Breandan-Gillanders/Masters_Project/Weekly_Reports/ProjectMeeting_2025_10_29.pptx

## Project Meeting

29/10/2025

## Summary of Past Week

- Literature Review:
  - Reading on methods for measuring reflection coefficient/extracting resonant frequency from wireless LC sensors.
  - Reading on existing sensors.
  - Taking notes on papers.
- Getting current circuit up and running:
  - Tested DDS output and filtered output on oscilloscope.
  - Looking over the Arduino code.
- Finalising project plan.

## Phase-Dip Method (current method)

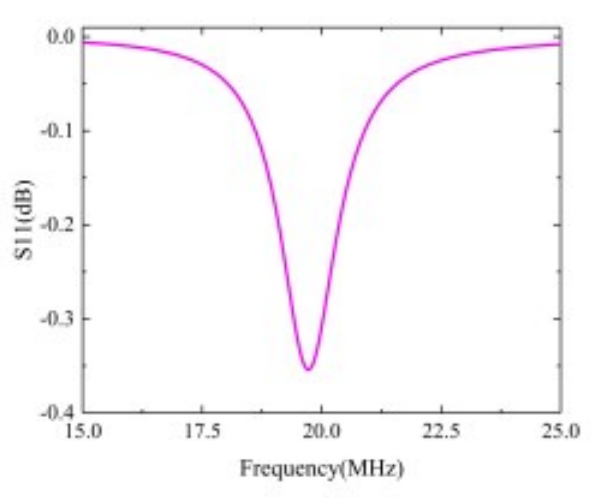
[picture p1: figure]

- Measure phase difference between DDS output and transmitted signal.
- Resonant frequency of sensor is ‘near’ the minimum in the phase curve.
- Dependent on coupling coefficient.
- Can be measured with phase detector.
- Requires compensation.

f_(phase−dip) ≈(1+(k^2)/4+1/(8Q^2))f_s

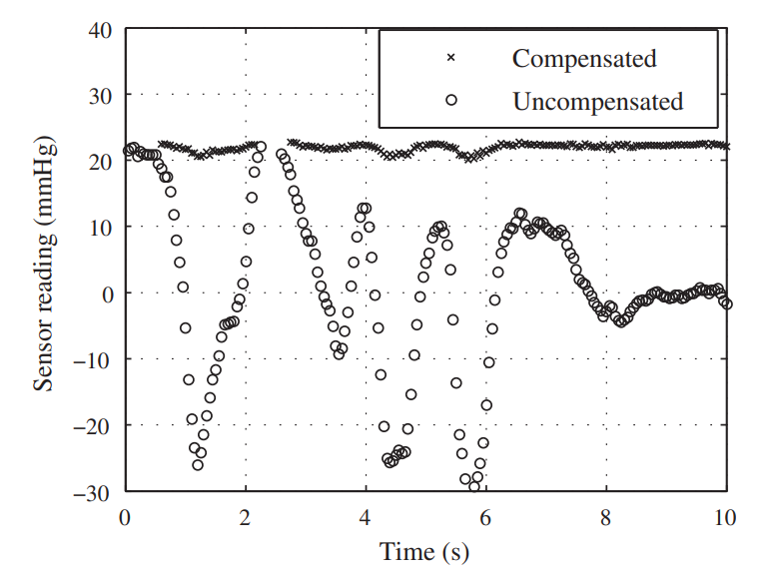
[picture p2: figure]

## Slide 4

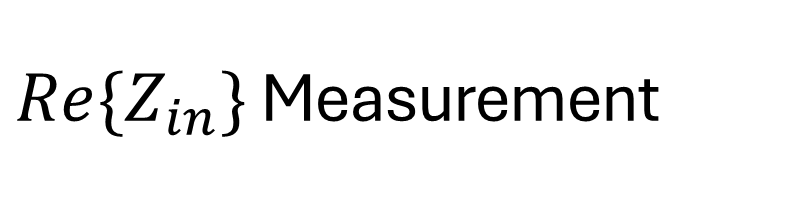
[picture p3: figure]

- Measures real component of readout coil impedance.
- The maximum occurs very close to the sensors resonance frequency.
- Minimally affected by coupling variations (independent of k).
- Can be measured with SWR bridge.

f_(max⁡(Re)) ≈(1+1/(4Q^2))f_s

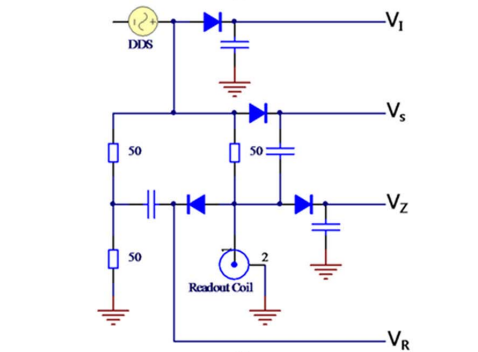
[picture p4: figure]
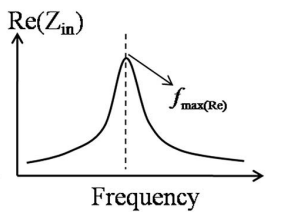
[picture p5: figure]

## Plan for Next Week

- Look into the phase shifter circuitry.
- Get full circuit running:
  - Need transmitter coil.
- Continue reviewing literature.
  - Look into operation of SWR bridge.
