Breandan-Gillanders/Masters_Project/Weekly_Reports/ProjectMeeting_2025_11_05.pptx

## Project Meeting

05/11/2025

## Summary of Past Week

- Literature Review:
  - Reading patents of existing readout systems.
- Getting current circuit up and running:
  - Looking into how the phase shifter works.
  - Simulating the phase shifter.
- Simulating different methods for extracting the resonance frequency.
  - Phase dip method
  - SWR Bridge (measuring real component of coil impedance)
  - Current Source Method (measuring real component of coil impedance)

## Vesselsens readout system

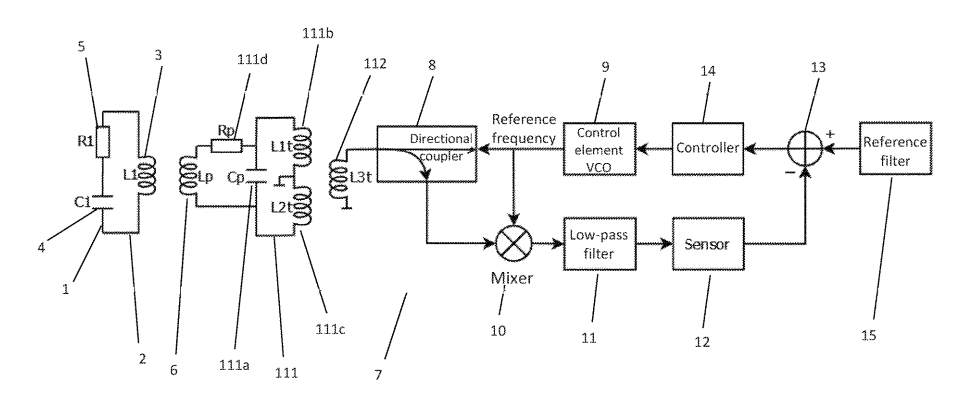
[picture p6: figure]

## Fire1 Readout System

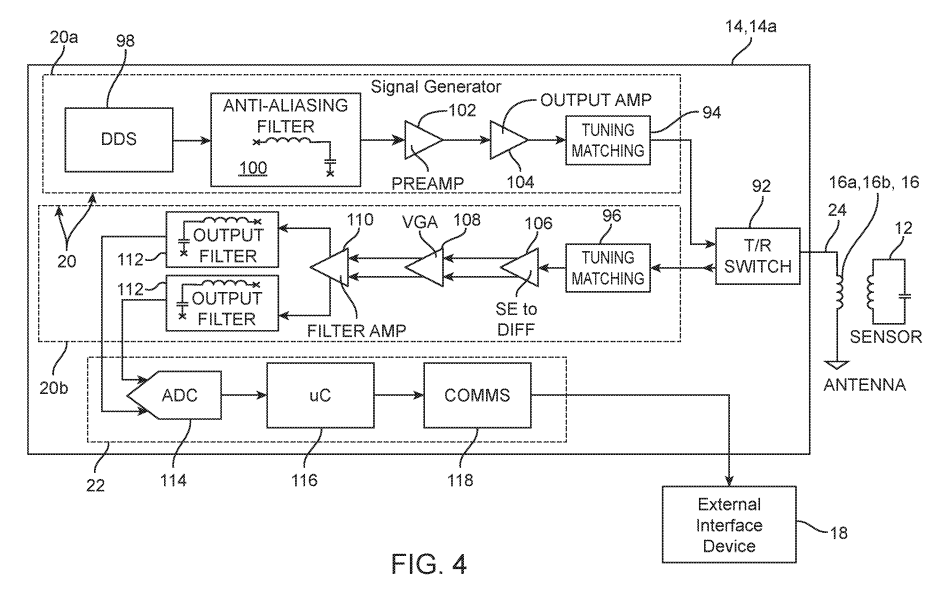
[picture p7: figure]

## Phase Shifter

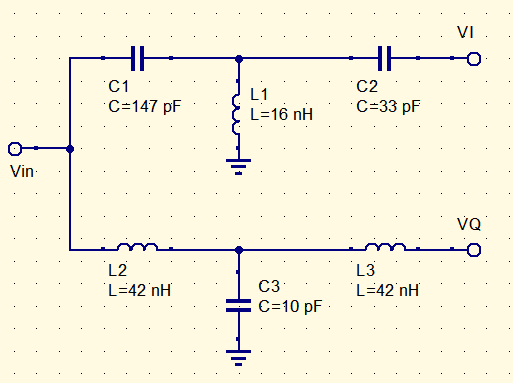
[picture p8: figure]
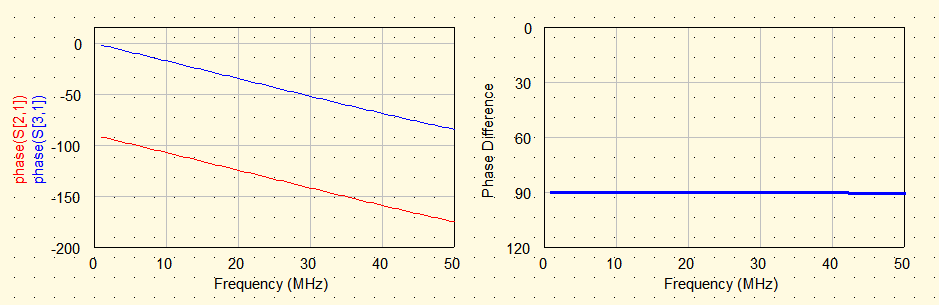
[picture p9: figure]

## Plan for Next Week

- Work on getting readings from current circuit.
- Continue Literature Review:
  - Review general methods for reading transmission/reflection coefficients.
