Breandan-Gillanders/Masters_Project/Papers/Litererature_Review_Notes.docx

## Wireless Readout of Passive LC Sensors [1]

This paper presents analytical expressions and practical circuitry for wirelessly reading passive LC resonant sensors using inductive coupling.

The paper first derives a mathematical model describing how the impedance at the readout coil depends on the sensor’s parameters and coupling.

The paper then evaluates previously used readout techniques, including phase dip detection and dip meter oscillators, showing that these approaches fail or become inaccurate when the sensor and readout coils are placed too close (i.e., when the coupling coefficient becomes large).

The paper then proposes an architecture to address these limitations based on measuring the real component of the input coil impedance.

## Wireless interrogation techniques for sensors utilizing inductively coupled resonance circuits [2]

This paper presents methods and instrumentation for wirelessly reading passive LC resonance sensors using inductive coupling. The authors develop a compact, portable impedance measurement unit capable of sweeping over a frequency range to record the phase and magnitude response of a resonant sensor. The system’s post-processing software identifies the resonance frequency and compensates for motion-induced errors caused by variations in the coupling coefficient.

The paper explains how the coupling between the reader and sensor coils affects the detected resonance frequency, leading to measurement ambiguity. To address this, a compensation algorithm relates the resonance peak frequency to the height of the phase peak, enabling correction for changes in coupling.

## Enhancing LC Sensor Telemetry via Magnetic Resonance Coupling [3]

This paper introduces a magnetic resonance–coupled reader designed to improve the signal strength and readout distance of passive LC wireless sensors. Conventional LC sensor systems suffer from weak coupling and limited range when sensor dimensions are reduced. To overcome this, the authors propose a resonant reader with a tuneable frequency, adjusted via a varactor diode, that can align its resonance with that of the sensor to achieve magnetic resonance coupling.

## Readout methods for an inductively coupled resonance sensor used in pressure garment application [4]

This paper details a portable device that performs frequency sweeps across the sensor’s resonance range while recording phase response data. A PC-based post-processing algorithm extracts two key features from the phase curve—the resonance peak frequency and height—and uses their relationship to correct for errors caused by changes in coil distance or alignment. The compensated resonance frequency is then converted into pressure using a calibrated sensitivity factor.

## An LC-Type Passive Wireless Humidity Sensor System With Portable Telemetry Unit [5]

The sensor is wirelessly interrogated using a custom-made telemetry unit based on a standing wave ratio (SWR) bridge that measures the real part of the readout coil impedance. This approach eliminates errors due to varying coupling coefficients that affect conventional phase-dip methods. The system uses a direct digital synthesizer (DDS) for frequency sweeps and a microcontroller to process and transmit data to a PC for visualization.

[1] R. Nopper, R. Niekrawietz, and L. Reindl, ‘Wireless readout of passive LC sensors’, IEEE Trans Instrum Meas, vol. 59, no. 9, pp. 2450–2457, Sep. 2010, doi: 10.1109/TIM.2009.2032966.

[2] T. Salpavaara, J. Verho, P. Kumpulainen, and J. Lekkala, ‘Wireless interrogation techniques for sensors utilizing inductively coupled resonance circuits’, Procedia Eng, vol. 5, pp. 216–219, Jan. 2010, doi: 10.1016/J.PROENG.2010.09.086.

[3] B. Bin Zhou, M. N. Zhang, M. Z. Xie, L. F. Wang, and Q. A. Huang, ‘Enhancing LC Sensor Telemetry via Magnetic Resonance Coupling’, Proceedings of IEEE Sensors, vol. 2019-October, Oct. 2019, doi: 10.1109/SENSORS43011.2019.8956818.

[4] T. Salpavaara, J. Verho, P. Kumpulainen, and J. Lekkala, ‘Readout methods for an inductively coupled resonance sensor used in pressure garment application’, Sens Actuators A Phys, vol. 172, no. 1, pp. 109–116, Dec. 2011, doi: 10.1016/J.SNA.2011.02.051.

[5] C. Zhang, L. F. Wang, J. Q. Huang, and Q. A. Huang, ‘An LC-type passive wireless humidity sensor system with portable telemetry unit’, Journal of Microelectromechanical Systems, vol. 24, no. 3, pp. 575–581, Jun. 2015, doi: 10.1109/JMEMS.2014.2333747.
