Breandan-Gillanders/Masters_Project/Inductions/Breandan-Gillanders-University-of-Galway-8211-Fire-Safety-Awareness-Training-University-of-Galway-–-Fire-Safety-Awareness-Trainin.pdf

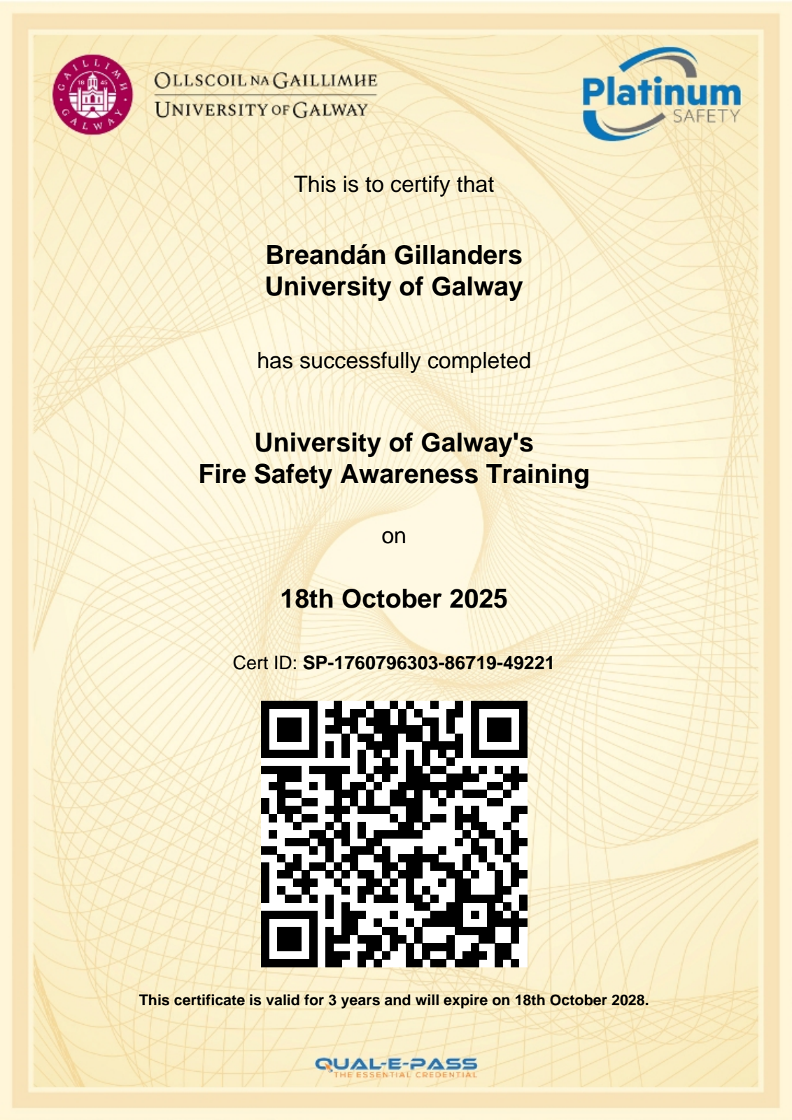
[picture p10: page 1]

This is to certify that

Breandán Gillanders
University of Galway

has successfully completed

University of Galway's
Fire Safety Awareness Training

on

18th October 2025

Cert ID: SP-1760796303-86719-49221

This certificate is valid for 3 years and will expire on 18th October 2028.

Powered by TCPDF (www.tcpdf.org)
