Breandan-Gillanders/Masters_Project/Inductions/CSWL2-25_Chemical Safety in the Workplace – Level 2 Certificate.pdf

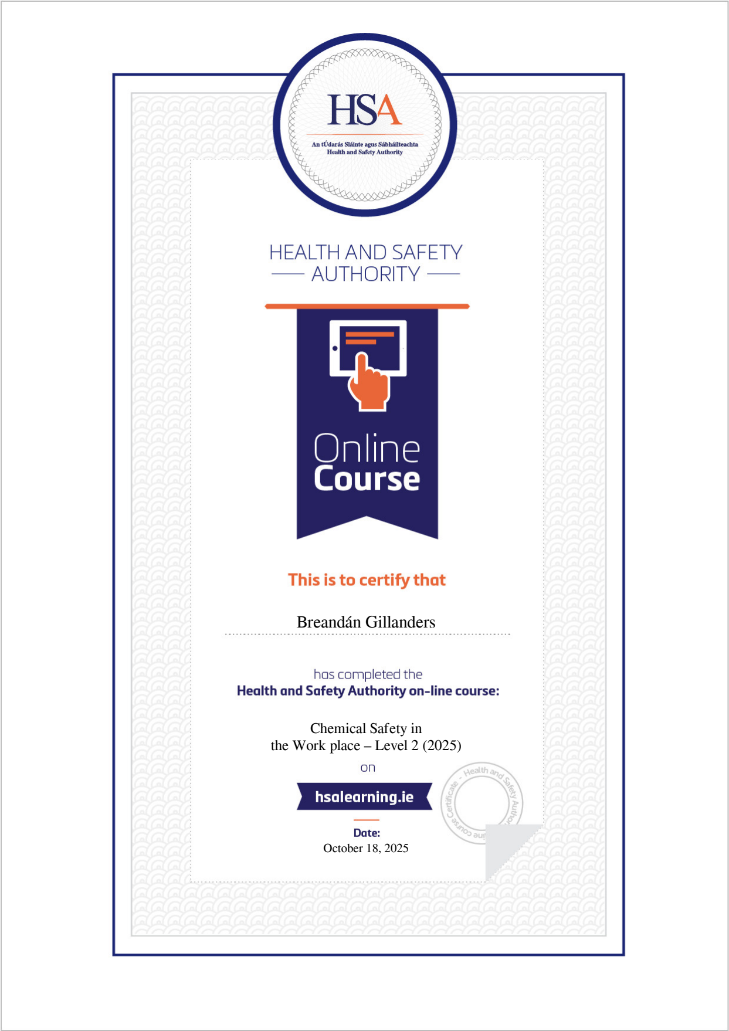
[picture p11: page 1]

### Breandán Gillanders

Chemical Safety in
the Work place – Level 2 (2025)

October 18, 2025

Powered by TCPDF (www.tcpdf.org)
