Breandan-Gillanders/Masters_Project/Testing/2025_10_24_DDS_TESTING/1MHz.png

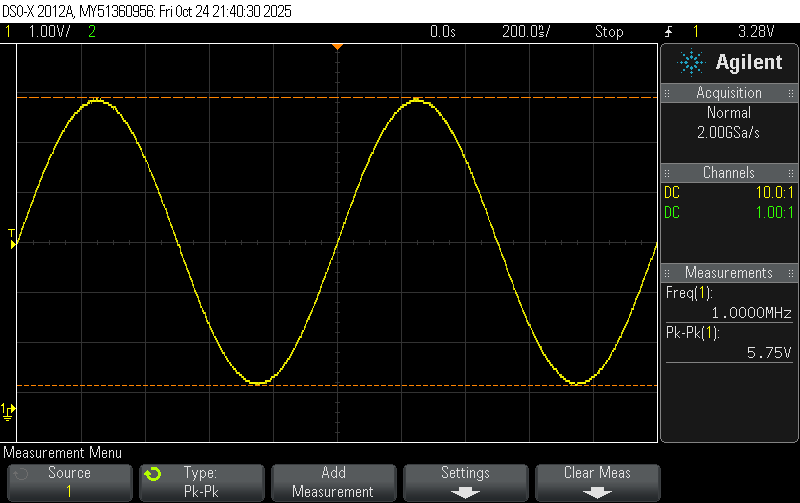
Testing/2025_10_24_DDS_TESTING/1MHz.png
