Breandan-Gillanders/Masters_Project/Testing/2025_10_24_DDS_TESTING/10MHz.png

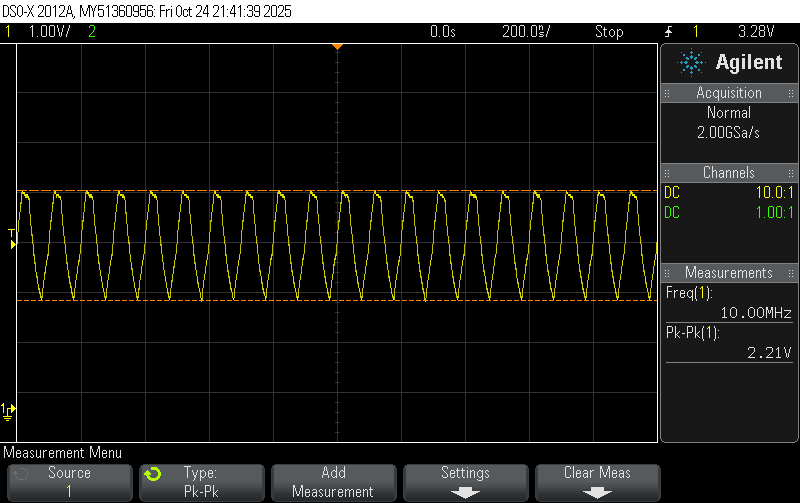
Testing/2025_10_24_DDS_TESTING/10MHz.png
