Breandan-Gillanders/Masters_Project/Testing/2025_10_24_DDS_TESTING/15MHz.png

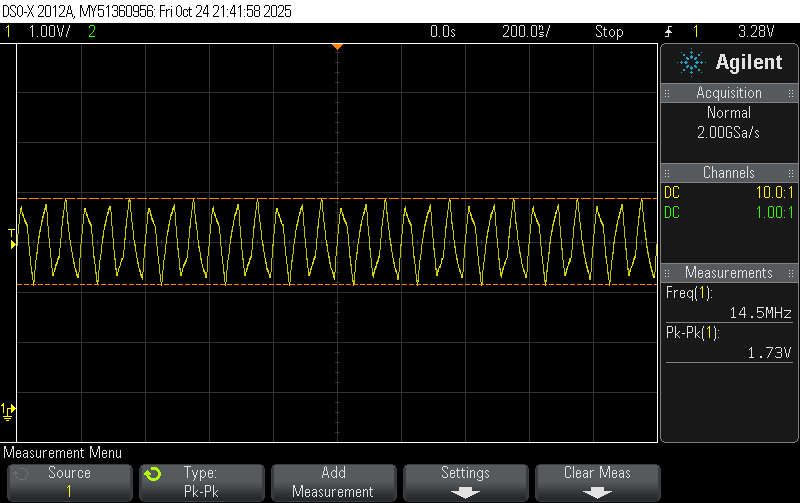
Testing/2025_10_24_DDS_TESTING/15MHz.png
