Breandan-Gillanders/Masters_Project/Inductions/CSW1-25_Chemical Safety in the Workplace 1 Identifying chemical hazards Certificate.pdf

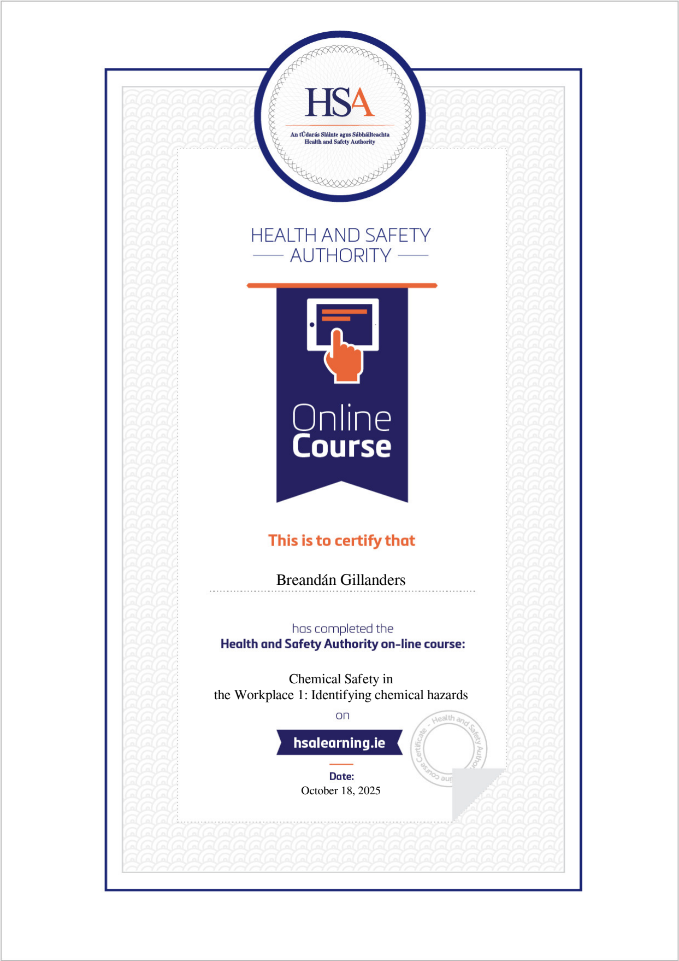
[picture p84: page 1]

### Breandán Gillanders

Chemical Safety in
the Workplace 1: Identifying chemical hazards

October 18, 2025

Powered by TCPDF (www.tcpdf.org)
