Breandan-Gillanders/Masters_Project/(commit log)

2025-10-31 Added papers and simulation files
    [readout_coil.sch, swr_bridge.sch]
2025-11-05 New simulations and weekly reports
    [current_source_method.sch, filter_test.sch, lphp_phase_shifter.sch, phase_dip.sch, phase_shifter_test.sch, reflection_coeff.sch, swr_bridge.sch, swr_bridge_test.sch]
2025-11-06 Updated simulations
    [phase_shifter_test.sch, reflection_coeff.sch]
